jk89/teensy40-6step-adc-bldc/images/circuit.png

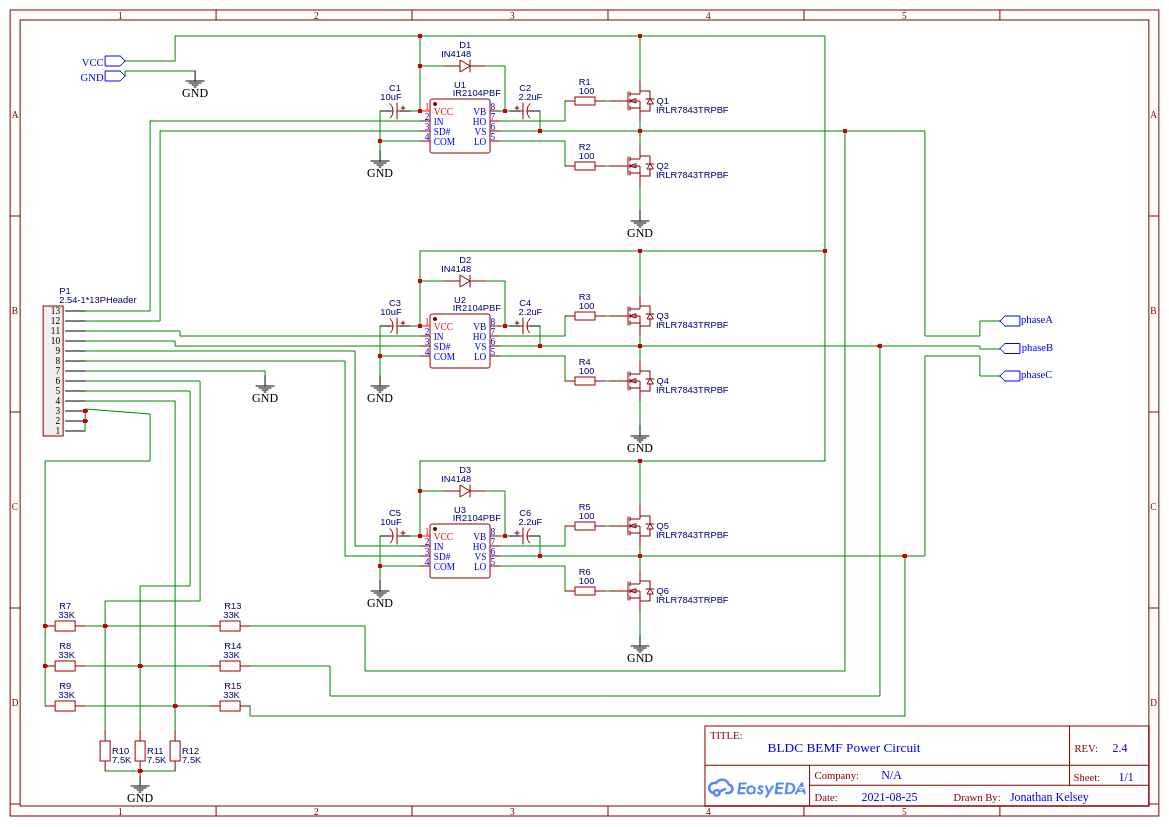
images/circuit.png
