jk89/teensy40-6step-adc-bldc/images/output-with-power-circuit-off-20khz(GOOD SIGNAL).png

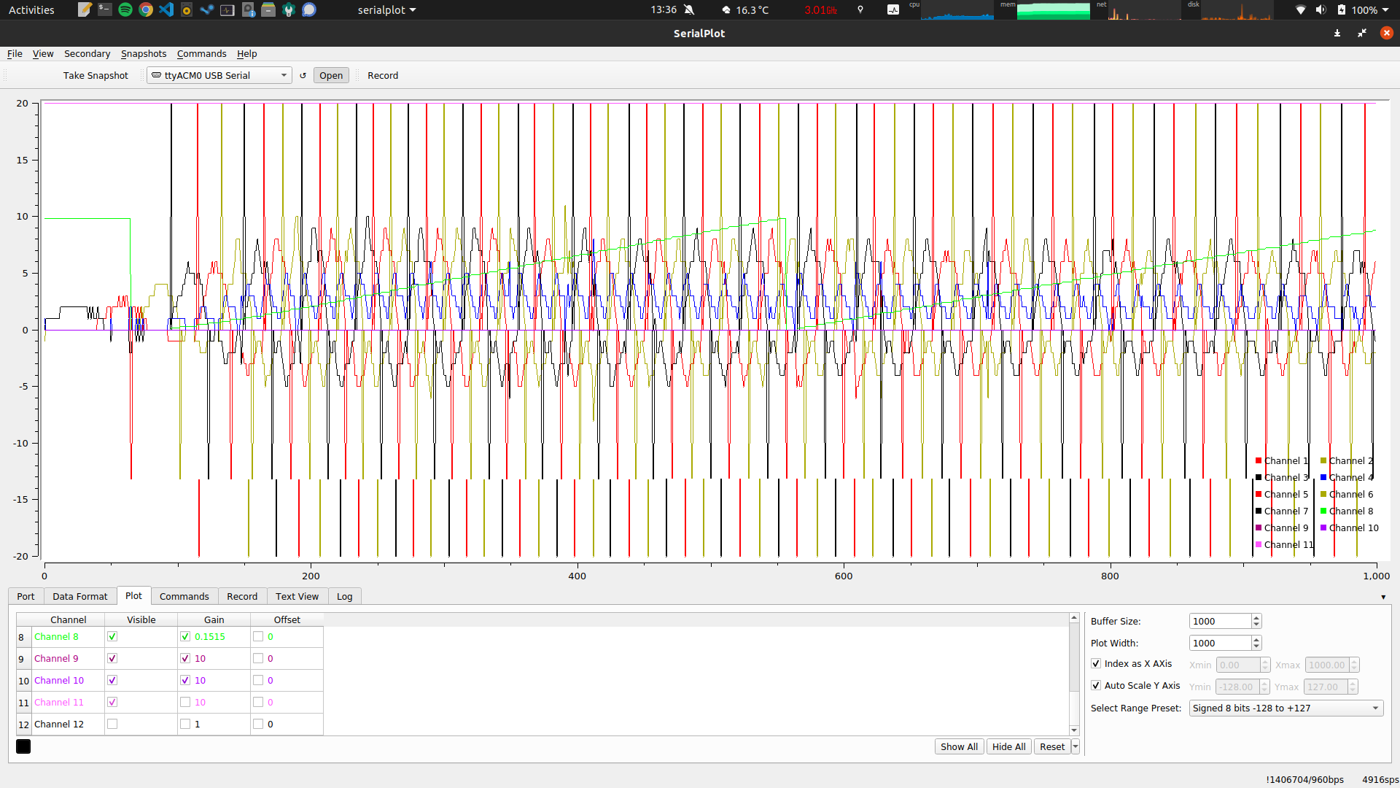
images/output-with-power-circuit-off-20khz(GOOD SIGNAL).png
