jk89/teensy40-6step-adc-bldc/images/output-with-power-circuit-on-20khz(BAD SIGNAL - ALMOST NO MOTION).png

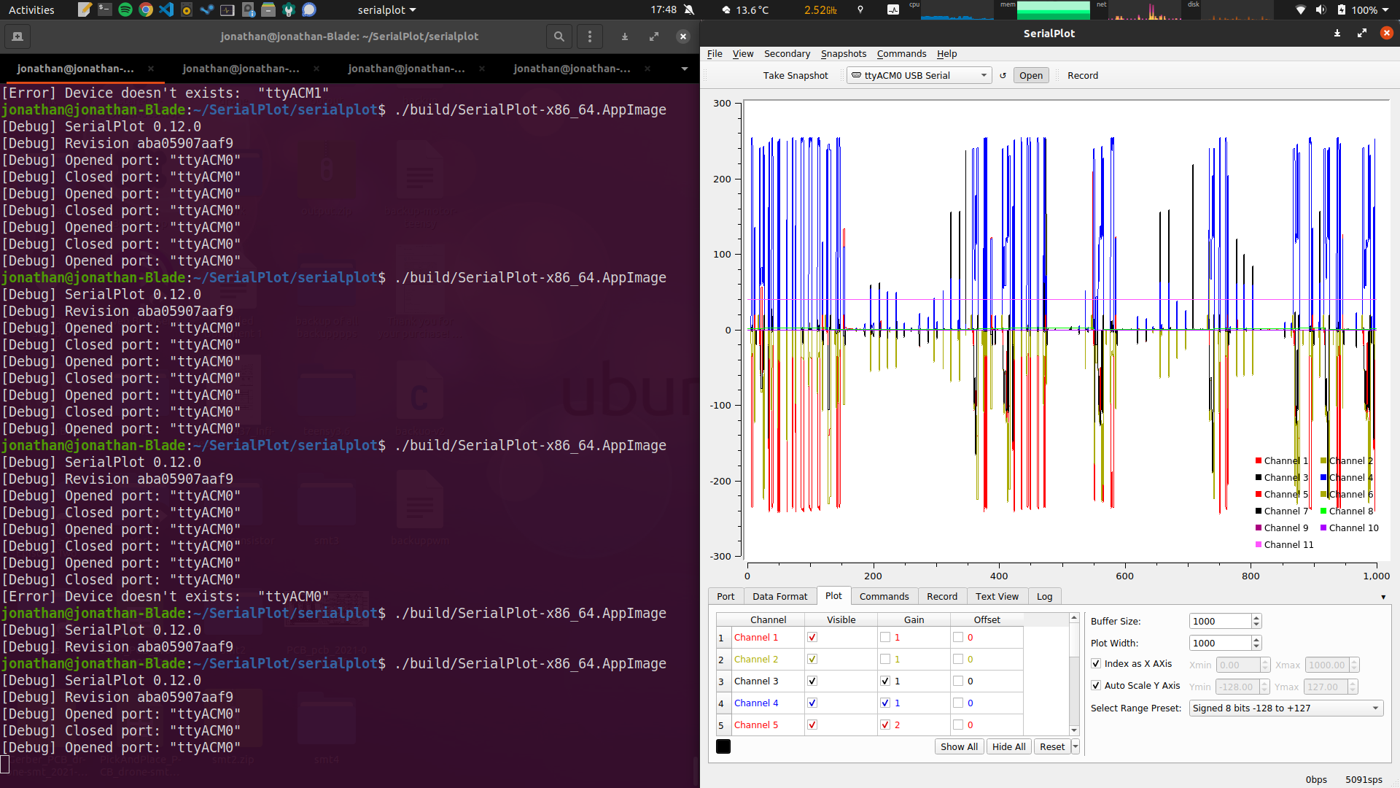
images/output-with-power-circuit-on-20khz(BAD SIGNAL - ALMOST NO MOTION).png
