jk89/teensy40-6step-adc-bldc/images/output-with-power-circuit-on-1950hz(MODERATE SIGNAL - SOME CONTINUOUS MOTION).png

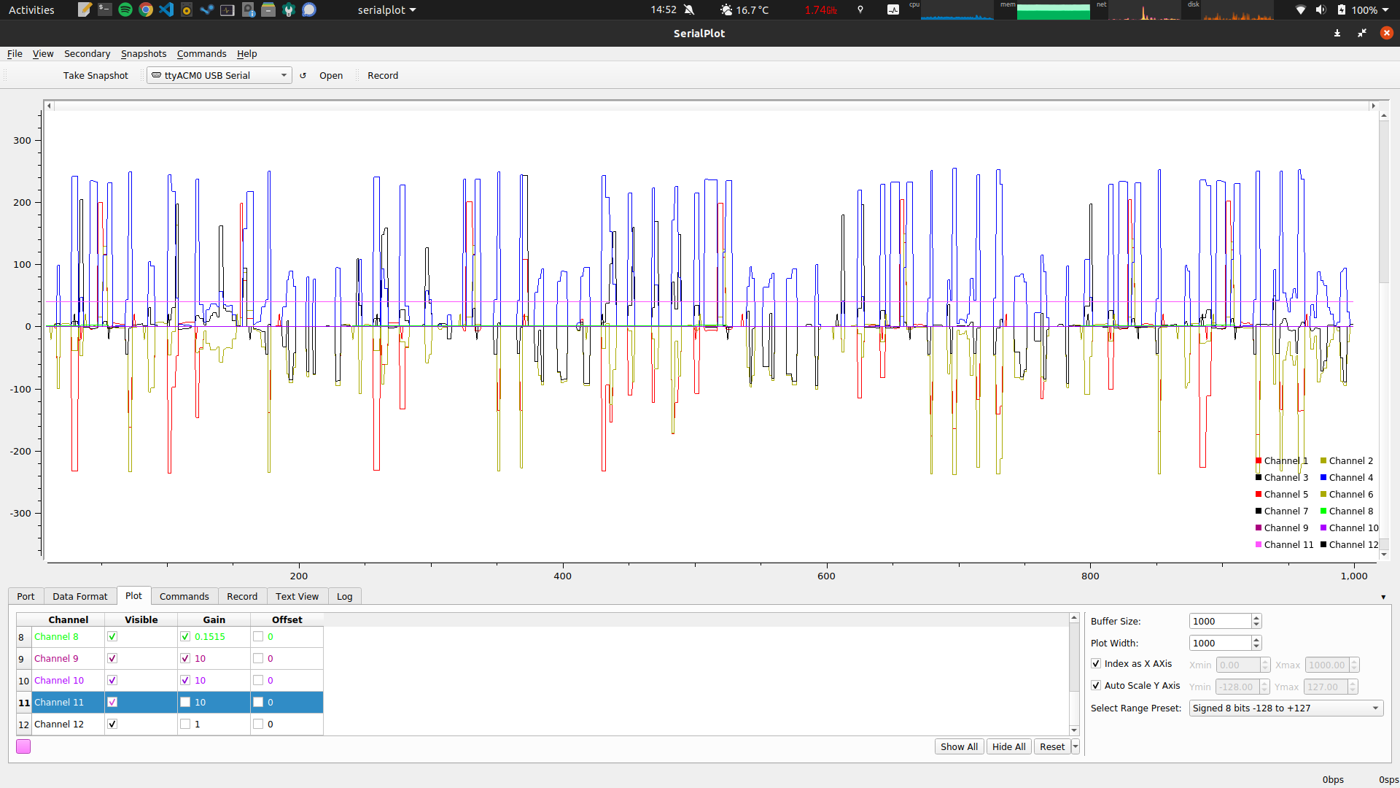
images/output-with-power-circuit-on-1950hz(MODERATE SIGNAL - SOME CONTINUOUS MOTION).png
